bananagunso/TA8201_audio_amp/ta8201ak_audio_amp.kicad_pcb

## KiCad design ta8201ak_audio_amp.kicad_pcb (2026-04-04)

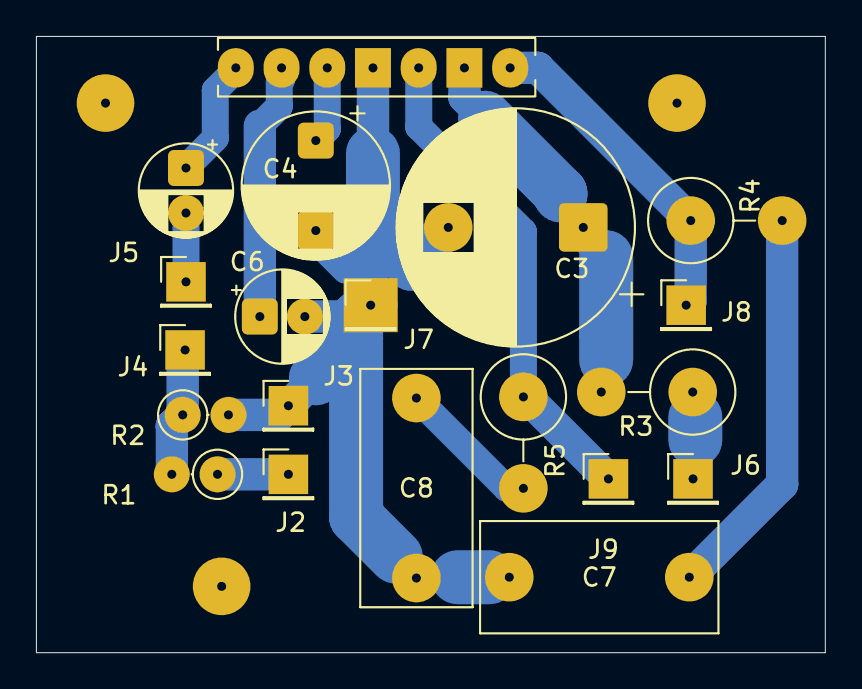
[picture p1: board ta8201ak_audio_amp.kicad_pcb from above]

Board: 2 copper layers, 43.8 x 34.2 mm, 23 parts (0 on the bottom side), 13 nets.

Parts:
C3: 1000uF; CP_Radial_D13.0mm_P7.50mm
C4: 220u; CP_Radial_D8.0mm_P5.00mm
C5: 4.7u; CP_Radial_D5.0mm_P2.50mm
C6: 47u; CP_Radial_D5.0mm_P2.50mm
C7, C8: 0.15u; C_Rect_L13.0mm_W6.0mm_P10.00mm_FKS3_FKP3_MKS4
H1, H2, H3: MountingHole; MountingHole_3.2mm_M3
J2: IN; PinHeader_1x01_P2.54mm_Vertical
J3: GND; PinHeader_1x01_P2.54mm_Vertical
J4: RV1_3; PinHeader_1x01_P2.54mm_Vertical
J5: RV1_2; PinHeader_1x01_P2.54mm_Vertical
J6: Vcc; PinHeader_1x01_P2.54mm_Vertical
J7: Gnd; PinHeader_1x01_P2.54mm_Vertical
J8: Out1; PinHeader_1x01_P2.54mm_Vertical
J9: Out2; PinHeader_1x01_P2.54mm_Vertical
R1: 200k; R_Axial_DIN0207_L6.3mm_D2.5mm_P2.54mm_Vertical
R2: 820k; R_Axial_DIN0207_L6.3mm_D2.5mm_P2.54mm_Vertical
R3: 2.2Ω; R_Axial_DIN0414_L11.9mm_D4.5mm_P5.08mm_Vertical
R4, R5: 2.2; R_Axial_DIN0414_L11.9mm_D4.5mm_P5.08mm_Vertical
U1: TA8201AK

Connections:
GND: C3.2, C4.2, C6.2, C7.2, C8.2, J3.1, J7.1, R2.2, U1.4 (GND)
unnamed: C7.1, R4.2
unnamed: C8.1, R5.2
unnamed: J2.1, R1.1
unnamed: J4.1, R1.2, R2.1
unnamed: C5.2, J5.1
unnamed: J8.1, R4.1, U1.7 (OUT-1)
unnamed: J9.1, R5.1, U1.5 (OUT-2)
unnamed: C5.1, U1.1 (IN)
unnamed: C6.1, U1.2 (NF)
unnamed: C4.1, U1.3 (R.F)
unnamed: C3.1, R3.2, U1.6 (VCC)
VCC: J6.1, R3.1
