bananagunso/TA8201_audio_amp/(commit log)

2025-12-02 抵抗560Ωを追加Cを3.3uF,33uFに変更
    [ta8201ak_audio_amp.kicad_pcb, ta8201ak_audio_amp.kicad_sch]
2025-12-02 配置の修正
    [ta8201ak_audio_amp.kicad_pcb]
2025-12-03 配置変更、ジャンパを減らす。
    [ta8201ak_audio_amp.kicad_pcb]
2025-12-03 配置変更、アッテネーター追加、ベタ追加。
    [ta8201ak_audio_amp.kicad_pcb, ta8201ak_audio_amp.kicad_sch]
2025-12-08 電解コンデンサの足幅修正
    [ta8201ak_audio_amp.kicad_pcb, ta8201ak_audio_amp.kicad_sch]
2025-12-17 発振が酷いので部品配置を変更して解決できた 2.2Ω以外の抵抗は無くても利得が大きすぎるといったことは無いとおもう。
    [ta8201ak_audio_amp.kicad_pcb, ta8201ak_audio_amp.kicad_sch]
2026-01-27 発振が酷いので配置の見直しと配線を太くした
    [ta8201ak_audio_amp.kicad_pcb, ta8201ak_audio_amp.kicad_sch]
2026-01-28 ドリル穴が大きかったのを修正
    [ta8201ak_audio_amp.kicad_pcb]
2026-01-28 ドリル穴の修正
    [ta8201ak_audio_amp.kicad_pcb]
2026-03-03 配置と配線を修正
    配線の修正
    [ta8201ak_audio_amp.kicad_pcb, ta8201ak_audio_amp.kicad_sch]
2026-03-03 仕切り直す
    [ta8201ak_audio_amp.kicad_pcb, ta8201ak_audio_amp.kicad_sch]
2026-03-03 エレキギター向けに抵抗やコンデンサを変更
    [ta8201ak_audio_amp.kicad_pcb, ta8201ak_audio_amp.kicad_sch]
2026-03-04 利得制限の抵抗は外した アッテネーターの合成抵抗をエレキギター向けに1Mに近づけた 高音補正用のセラミックコンデンサとボリュームを追加
    [ta8201ak_audio_amp.kicad_pcb, ta8201ak_audio_amp.kicad_sch]
2026-03-04 GNDが細い一点で繋がっていたので少しでも太くなるよう配置修正
    [ta8201ak_audio_amp.kicad_pcb]
2026-03-05 ベタGNDをやめ、音声がICに入るまでのGNDと電源のGNDを分離した。
    [ta8201ak_audio_amp.kicad_pcb, ta8201ak_audio_amp.kicad_sch]
2026-03-06 パッド: 円形 Φ2.0 / 四角 2.0×2.0 / SIP 1.6×2.2 配線: 電源 2.0 / 信号 1.5 クリアランス: 0.5 ティアドロップ適用 ネジ穴をスルーホールにして真ん中が白抜きになるように 直角を排除
    [ta8201ak_audio_amp.kicad_pcb]
2026-03-06 ICのフットプリントを修正
    [ta8201ak_audio_amp.kicad_pcb]
2026-03-06 ブライトスイッチのコンデンサはスイッチ直付けにして配置変更
    [ta8201ak_audio_amp.kicad_pcb, ta8201ak_audio_amp.kicad_sch]
2026-03-12 パッドの大きさを修正
    [ta8201ak_audio_amp.kicad_pcb]
2026-03-12 配線の太さ、パッドの大きさを大きくした
    [ta8201ak_audio_amp.kicad_pcb]
2026-04-04 ハムノイズ対策に抵抗を追加してGNDの取り方を変更
    [ta8201ak_audio_amp.kicad_pcb, ta8201ak_audio_amp.kicad_sch]
